quetchen/heart/hardware/heart/heart.xlsx

Partlist exported from /Users/quetchen/Documents/EAGLE/projects/Heart/heart.sch at 10/8/24 1:07‚ÄØPM
 |  |  |  |  |  |  |  | Digi-Key |  | Number per board | Number total | Mouser
Part Value Device Package Description POPULARITY PROD_ID SPICEPREFIX VALUE |  |  |  |  |  |  |  | Digi-Key | Price |  |  | PN | Price | order qty | Ext price
 |  |  |  | Battery 350mAh |  |  |  | 1528-4237-ND | $5.95 | 0 | 0 | 485-4237 | $5.950 | 0 | $0.00
 |  |  |  | Battery 400mAh |  |  |  |  |  | 1 | 6 | 485-3898 | $6.950 | 6 | $41.70
 |  |  |  | LED |  |  |  |  |  | 2 | 12 | 474-COM-12999 | $3.190 | 13 | $41.47
C1 C4 | 10n | C-USC0603 | C0603 | CAPACITOR, American symbol | 37 |  | C | 478-KGM15AR71H103KMCT-ND | $0.02 | 2 | 12 | 187-CL10B103KB85PNC | $0.022 | 20 | $0.44
C2 C3 C7 C9 | 0.1u | C-USC0603 | C0603 | CAPACITOR, American symbol | 37 |  | C |  |  | 4 | 24 | 187-CL10B104KA8NNNC | $0.014 | 40 | $0.56
C5 C6 C8 | 10u | C-USC0805 | C0805 | CAPACITOR, American symbol | 63 |  | C |  |  | 3 | 18 | 81-GRM188R61E106KA3J | $0.110 | 25 | $2.75
CHG |  | LEDCHIP-LED0805 | CHIP-LED0805 | LED |  |  |  |  |  | 1 | 6 | 720-LSR976-NR-1 | $0.147 | 10 | $1.47
CN1 |  | JST_2PIN-THM | JST-PH-2-THM | JST 2-Pin Connectors of various flavors |  |  |  |  |  | 1 | 6 | 571-440055-2 | $0.090 | 10 | $0.90
ISP | AVR_SPI_PROG_3X2NS | AVR_SPI_PROG_3X2NS | 2X3-NS | AVR ISP 6 Pin |  |  |  |  |  | 0 | 0 | 571-5-146257-3 | $0.600 | 0 | $0.00
J1 | WM9734TR-ND | USB_MICRO-B_FEMALE-SMT-VERT | USB-B-MICRO-SMD_VERT | USB Type Micro-B Connector |  | CONN-13534 |  | WM9734CT-ND |  | 1 | 6 | 538-105133-0001 | $0.839 | 10 | $8.39
R1 |  |  |  |  |  |  |  |  |  | 1 | 6 | 603-RC0603FR-105K1L | $0.011 | 15 | $0.16
R2 R3 | 4.7K | R-US_R0603 | R0603 | RESISTOR, American symbol | 77 |  | R |  |  | 2 | 12 | 279-CRGS0603J4K7 | $0.114 | 25 | $2.85
R4 R5 | 330 | R-US_R0603 | R0603 | RESISTOR, American symbol | 77 |  | R |  |  | 2 | 12 | 279-CRG0603F330R | $0.010 | 25 | $0.25
R6 R7 | 10K | R-US_R0603 | R0603 | RESISTOR, American symbol | 77 |  | R |  |  | 2 | 12 | 71-CRCW0603J-10K-E3 | $0.016 | 25 | $0.40
S1 |  | EG1218S | EG1218 | SLIDING SWITCH |  |  |  |  |  | 1 | 6 | 612-EG1218 | $0.750 | 7 | $5.25
U1 | ATTINY85 | ATTINY85 | ATTINY85 |  |  | IC-09092 |  |  |  | 1 | 6 | 556-ATTINY85-20SU | $1.500 | 10 | $15.00
U2 | MCP73831/OT | MCP73831/OT | SOT23-5L | MCP73831/2 |  |  |  |  |  | 1 | 6 | 579-MCP73831T-2ACIOT | $0.760 | 12 | $9.12
U3 U4 | AT42QT1010SOT23 | AT42QT1010SOT23 | SOT23-6 | Atmel AT42QT1010 |  |  |  |  |  | 2 | 12 | 556-AT42QT1010-TSHR | $0.770 | 16 | $12.32
F1 |  |  |  |  |  |  |  |  |  | 1 | 6 | 652-MF-FSML035/8-2 | $0.969 | 10 | $9.69
 |  |  |  | Flux |  |  |  |  |  |  | 1 | 910-CQ4LF | $7.950 | 1 | $7.95
 |  |  |  | Fine solder
Board fabrication |  |  |  |  |  |  |  |  |  |  |  |  | $10.000 | 3 | $30.00
Total |  |  |  |  |  |  |  |  |  |  |  |  |  |  | $190.67
