quetchen/heart/hardware/heart/heart.pdf

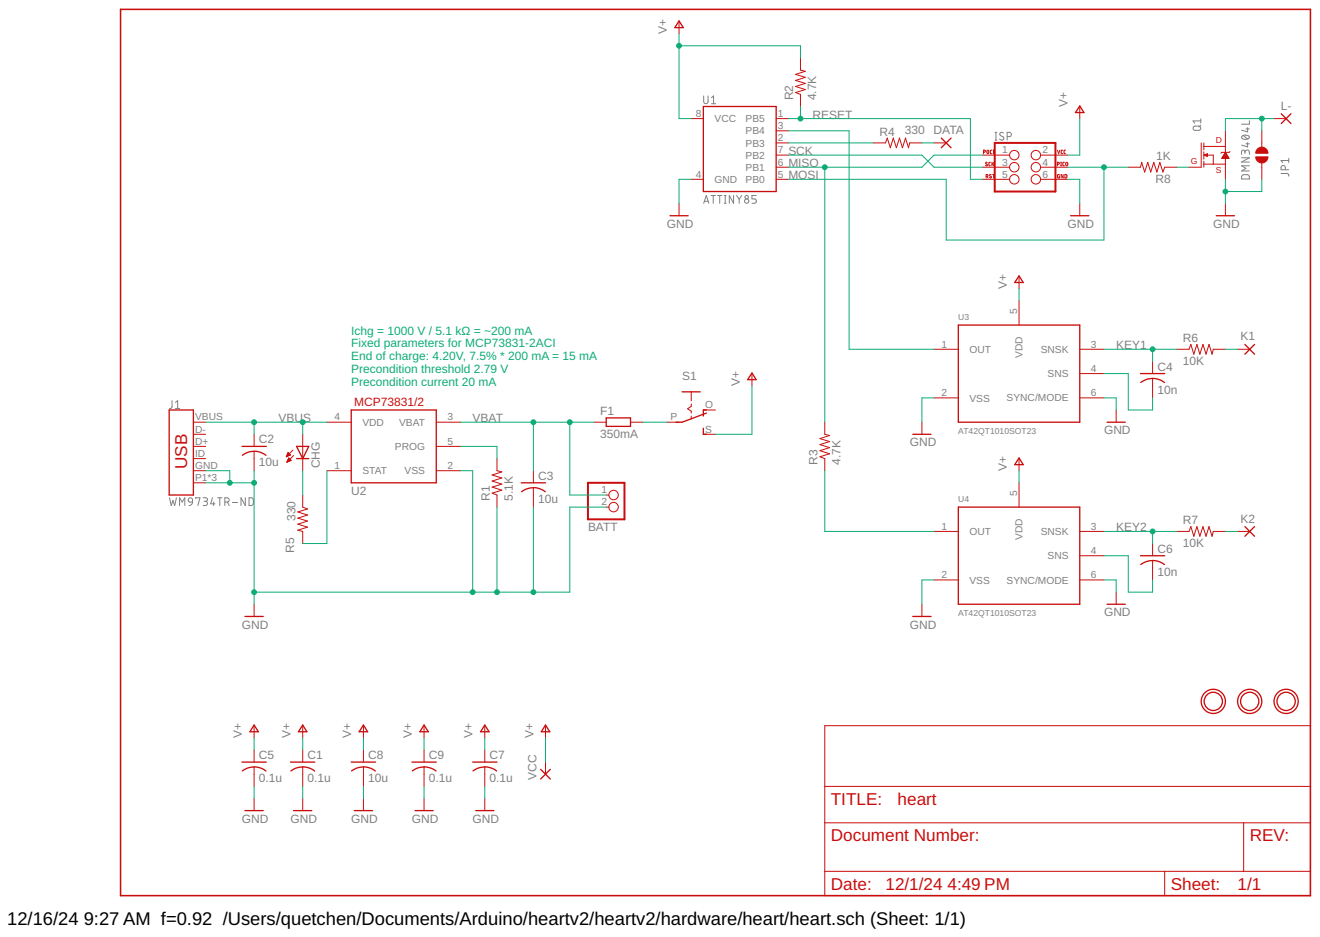
[picture p4: page 1]

Ichg = 1000 V / 5.1 kΩ = ~200 mA
Fixed parameters for MCP73831-2ACI
End of charge: 4.20V, 7.5% * 200 mA = 15 mA
Precondition threshold 2.79 V
Precondition current 20 mA
MCP73831/2
3 VDD

Document Number: | REV:

Date: 12/1/24 4:49 PM | Sheet: 1/1

12/16/24 9:27 AM f=0.92 /Users/quetchen/Documents/Arduino/heartv2/heartv2/hardware/heart/heart.sch (Sheet: 1/1)
