quetchen/heart/hardware/elephant/elephant.pdf

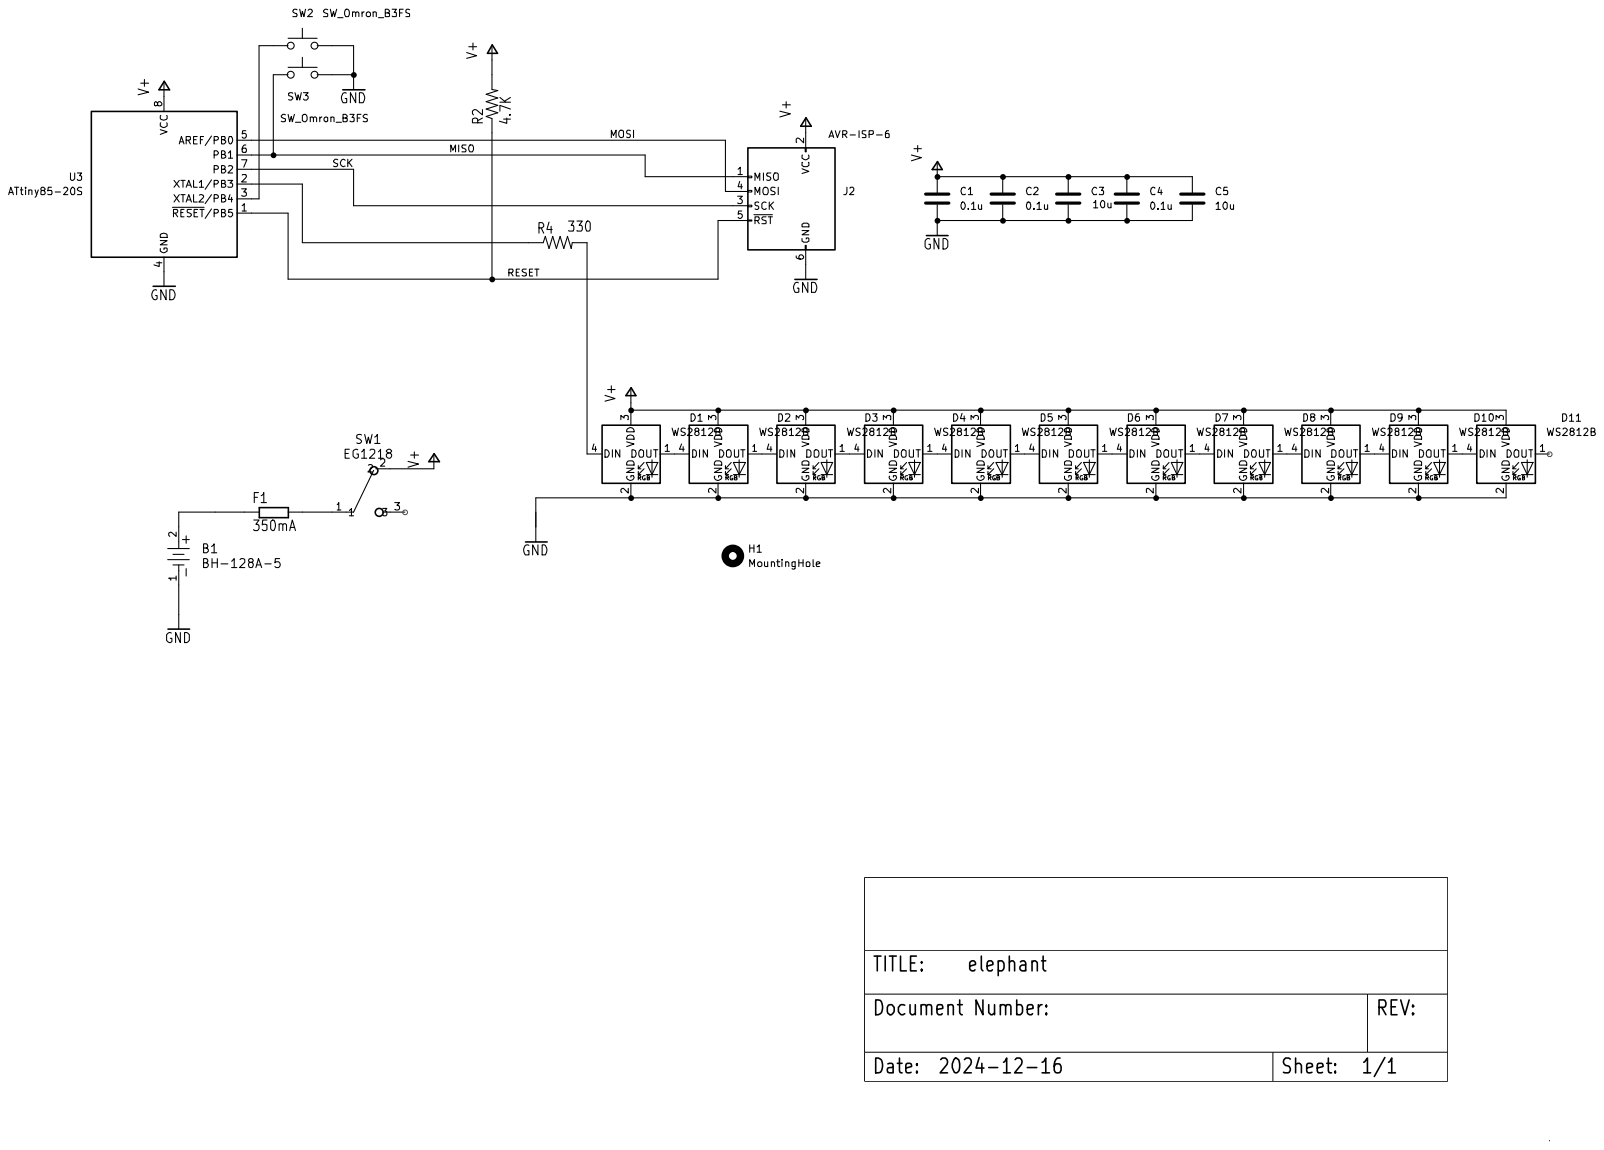
[picture p5: page 1]
