quetchen/heart/hardware/elephant/elephant.kicad_pcb

## KiCad design hardware/elephant/elephant.kicad_pcb (2024-12-16)

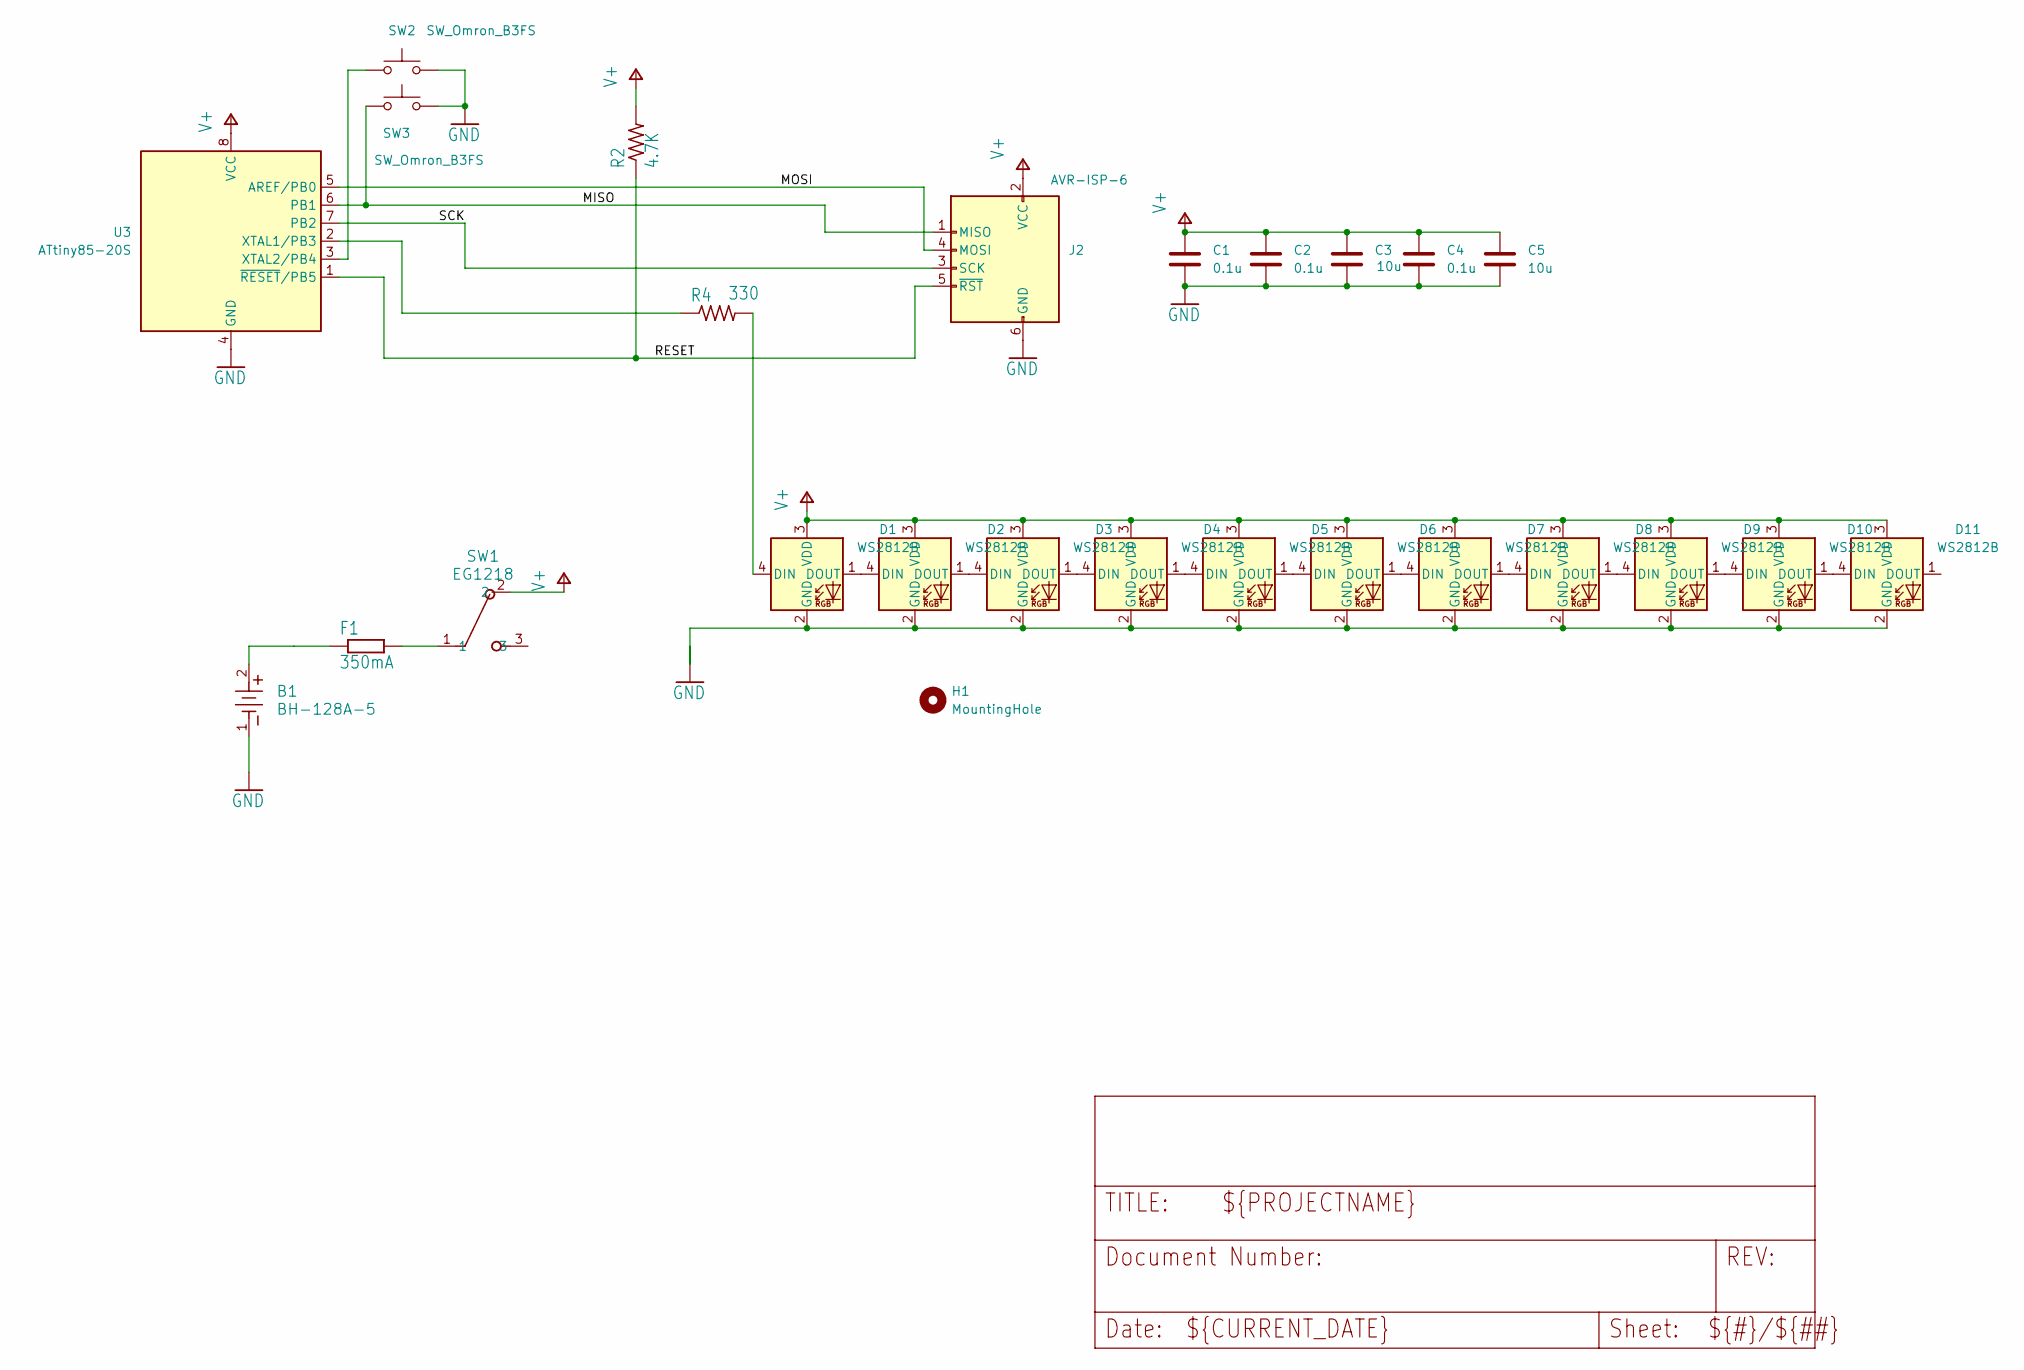
[picture p6: schematic elephant.kicad_sch]

Parts:
B1: BH-128A-5; BAT_BH-128A-5_ADM
C1, C2, C4: 0.1u; C_0603_1608Metric_Pad1.08x0.95mm_HandSolder
C3, C5: 10u; C_0603_1608Metric_Pad1.08x0.95mm_HandSolder
D1, D2, D3, D4, D5, D6, D7, D8, D9, D10, D11: WS2812B; LED_D5.0mm-4_RGB
F1: 350mA; R_0603_1608Metric_Pad0.98x0.95mm_HandSolder
H1: MountingHole; MountingHole_2.5mm
J2: AVR-ISP-6; IDC-Header_2x03_P2.54mm_Vertical
R2: 4.7K; R_0603_1608Metric_Pad0.98x0.95mm_HandSolder
R4: 330; R_0603_1608Metric_Pad0.98x0.95mm_HandSolder
SW1: EG1218; SW_1218_EWI
SW2, SW3: SW_Omron_B3FS; SW_SPST_Omron_B3FS-100xP
U3: ATtiny85-20S; SOIC-8W_5.3x5.3mm_P1.27mm

Connections:
/MISO: J2.1 (MISO), SW3.1, U3.6 (PB1)
/MOSI: J2.4 (MOSI), U3.5 (AREF/PB0)
/RESET: J2.5 (~RST), R2.1, U3.1 (~RESET/PB5)
/SCK: J2.3 (SCK), U3.7 (PB2)
GND: B1.1, C1.2, C2.2, C3.2, C4.2, C5.2, D1.2 (GND), D2.2 (GND), D3.2 (GND), D4.2 (GND), D5.2 (GND), D6.2 (GND), D7.2 (GND), D8.2 (GND), D9.2 (GND), D10.2 (GND), D11.2 (GND), J2.6 (GND), SW2.2, SW3.2, U3.4 (GND)
unnamed: B1.2, F1.1
unnamed: D1.4 (DIN), R4.2
unnamed: D1.1 (DOUT), D2.4 (DIN)
unnamed: D2.1 (DOUT), D3.4 (DIN)
unnamed: D3.1 (DOUT), D4.4 (DIN)
unnamed: D4.1 (DOUT), D5.4 (DIN)
unnamed: D5.1 (DOUT), D6.4 (DIN)
unnamed: D6.1 (DOUT), D7.4 (DIN)
unnamed: D7.1 (DOUT), D8.4 (DIN)
unnamed: D8.1 (DOUT), D9.4 (DIN)
unnamed: D9.1 (DOUT), D10.4 (DIN)
unnamed: D10.1 (DOUT), D11.4 (DIN)
unnamed: F1.2, SW1.1
unnamed: R4.1, U3.2 (XTAL1/PB3)
unnamed: SW2.1, U3.3 (XTAL2/PB4)
V+: C1.1, C2.1, C3.1, C4.1, C5.1, D1.3 (VDD), D2.3 (VDD), D3.3 (VDD), D4.3 (VDD), D5.3 (VDD), D6.3 (VDD), D7.3 (VDD), D8.3 (VDD), D9.3 (VDD), D10.3 (VDD), D11.3 (VDD), J2.2 (VCC), R2.2, SW1.2, U3.8 (VCC)

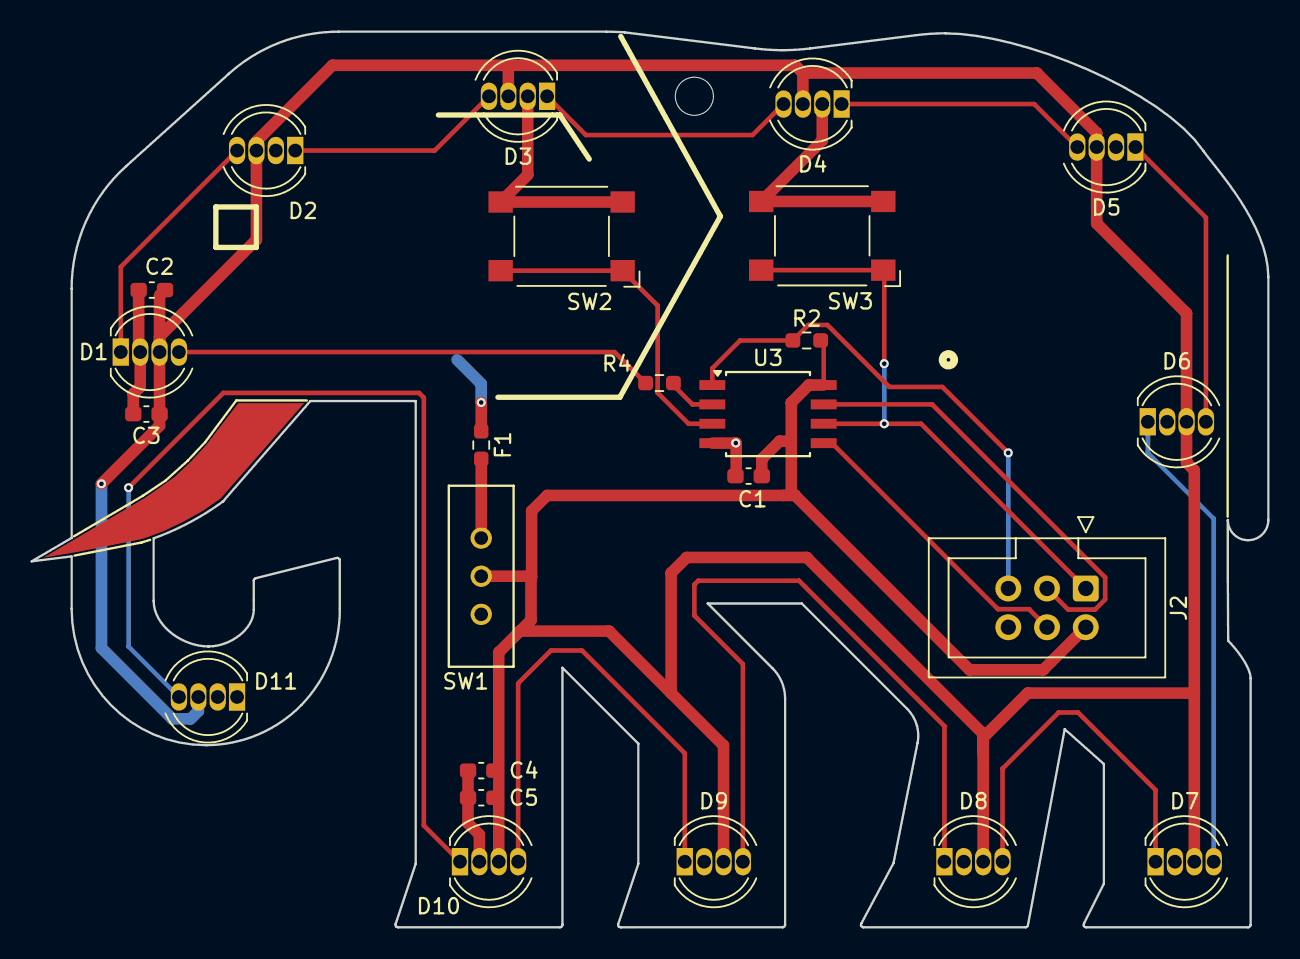
[picture p7: board elephant.kicad_pcb from above]

Board: 2 copper layers, 81.1 x 58.7 mm, 26 parts (1 on the bottom side), 21 nets.
