quetchen/heart/hardware/heart/heart.brd

## EAGLE design hardware/heart/heart.brd (2024-12-16)

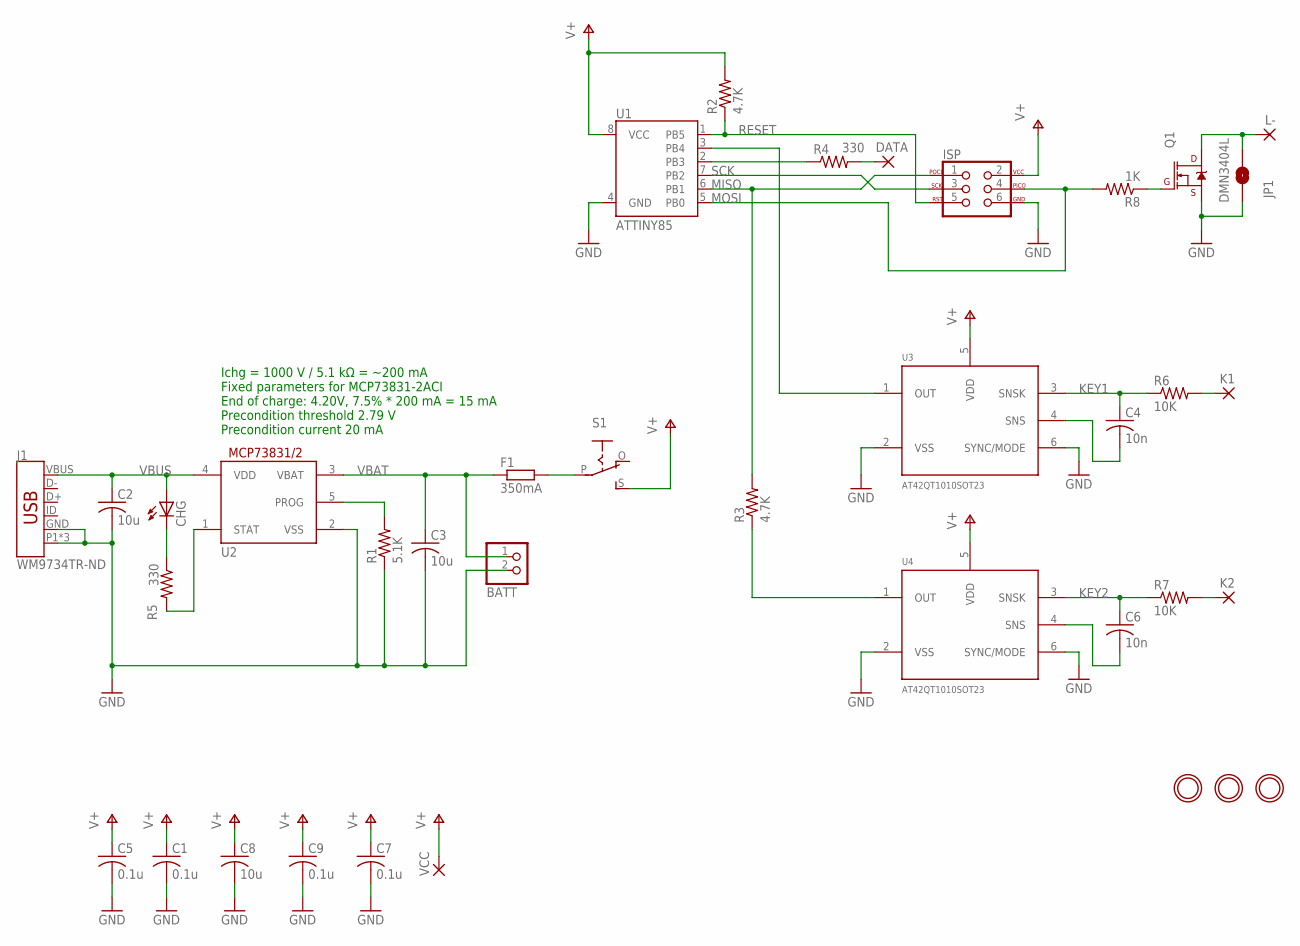
[picture p8: schematic heart.sch]

Parts:
BATT: JST_2PIN-THM-RA; JST-PH-2-THM-RA
C1, C5, C7, C9: 0.1u; C0603
C2, C3, C8: 10u; C0603
C4, C6: 10n; C0603
CHG: LEDCHIP-LED0805; CHIP-LED0805
DATA: 2,15/1,0
F1: 350mA; R0603
ISP: AVR_SPI_PROG_3X2PTH; 2X3
J1: WM9734TR-ND; USB-B-MICRO-SMD_VERT
JP1: JUMPER-SMT_2_NO_NO-SILK; SMT-JUMPER_2_NO_NO-SILK
K1, K2: 2,15/1,0
L-: 2,15/1,0
Q1: DMN3404L; SOT23-3
R1: 5.1K; R0603
R2, R3: 4.7K; R0603
R4, R5: 330; R0603
R6, R7: 10K; R0603
R8: 1K; R0603
S1: EG1218S; EG1218
U1: ATTINY85
U2: MCP73831/OT; SOT23-5L
U3, U4: AT42QT1010SOT23; SOT23-6
U$1, U$2, U$4: MICROBUILDER_MOUNTINGHOLE2.0; MICROBUILDER_MOUNTINGHOLE_2.0_PLATED
VCC: 1,6/0,9

Connections:
GND: BATT.2 (1), C1.2, C2.2, C3.2, C5.2, C7.2, C8.2, C9.2, ISP.6, J1.GND, J1.P1 (SHIELD), J1.P2 (SHIELD), J1.P3 (SHIELD), JP1.1, Q1.2 (S), R1.1, U1.4 (GND), U2.2 (VSS), U3.2 (VSS), U3.6 (SYNC/MODE), U4.2 (VSS), U4.6 (SYNC/MODE)
KEY1: C4.1, R6.1, U3.3 (SNSK)
KEY2: C6.1, R7.1, U4.3 (SNSK)
KOUT1: U1.3 (PB4), U3.1 (OUT)
KOUT2: R3.1, U4.1 (OUT)
LED_DATA: DATA.1, R4.2
LED_PIN: R4.1, U1.2 (PB3)
MISO: ISP.1, R3.2, U1.6 (PB1)
MOSI: ISP.4, R8.2, U1.5 (PB0)
unnamed: F1.2, S1.P
unnamed: K1.1, R6.2
unnamed: K2.1, R7.2
unnamed: C4.2, U3.4 (SNS)
unnamed: JP1.2, L-.1, Q1.3 (D)
unnamed: Q1.1 (G), R8.1
unnamed: CHG.C, R5.1
unnamed: C6.2, U4.4 (SNS)
PROG: R1.2, U2.5 (PROG)
RESET: ISP.5, R2.1, U1.1 (PB5)
SCK: ISP.3, U1.7 (PB2)
STAT: R5.2, U2.1 (STAT)
V+: C1.1, C5.1, C7.1, C8.1, C9.1, ISP.2, R2.2, S1.S, U1.8 (VCC), U3.5 (VDD), U4.5 (VDD), VCC.1
VBAT: BATT.1 (2), C3.1, F1.1, U2.3 (VBAT)
VBUS: C2.1, CHG.A, J1.VBUS, U2.4 (VDD)

Notes on the sheet:
Ichg = 1000 V / 5.1 kΩ = ~200 mA Fixed parameters for MCP73831-2ACI End of charge: 4.20V, 7.5% * 200 mA = 15 mA Precondition threshold 2.79 V Precondition current 20 mA

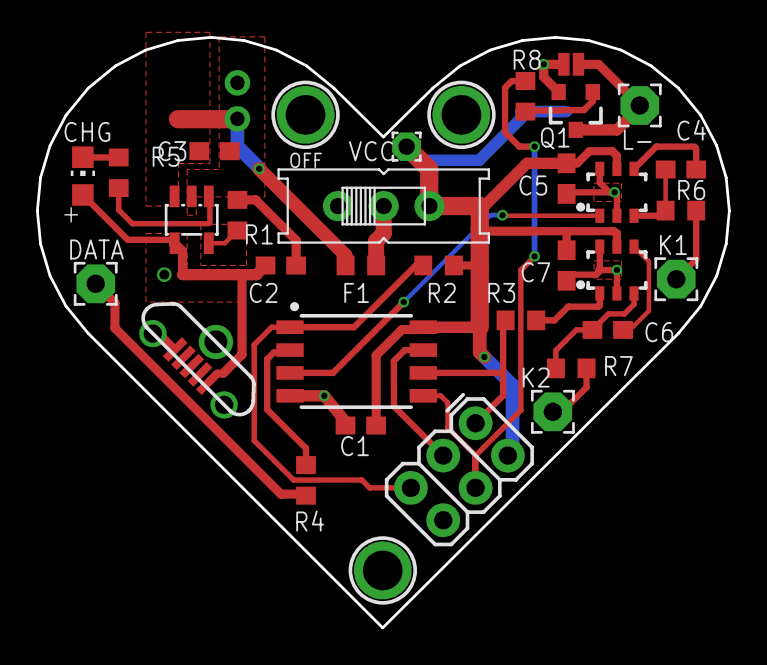
[picture p9: board heart.brd from above]

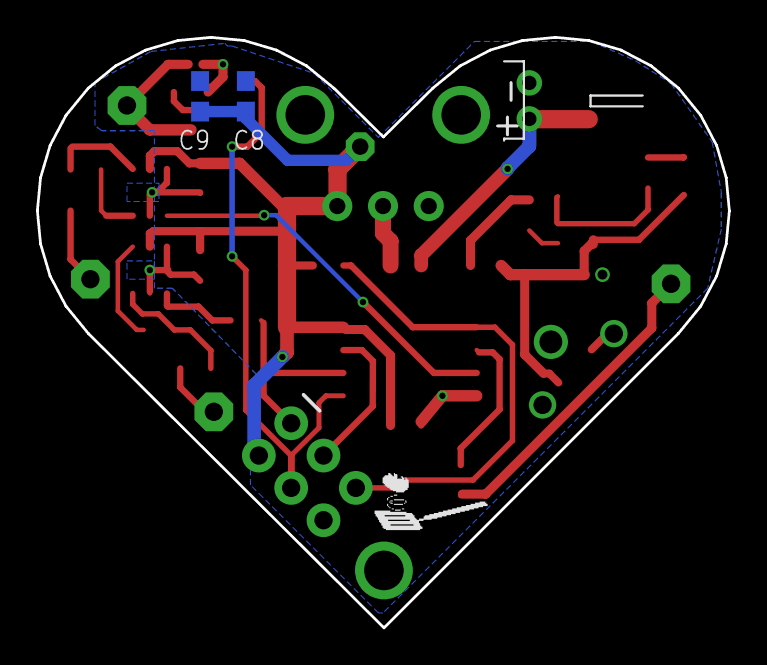
[picture p10: board heart.brd from below]

Board: 2 copper layers, 38.4 x 32.8 mm, 37 parts (3 on the bottom side), 24 nets.
